lm154-hdm/kniffomat/README.md

# **Kniffomat 🎲**
So you want to build a Kniffomat, a dice rolling automata for all your dice needs. The Kniffomat supports up to 6 dice and can be used to play games like Kniffel, Super-Six and Farkle. This Readme shows you which parts you need and what steps to follow to build your own Kniffomat.

## Trailer
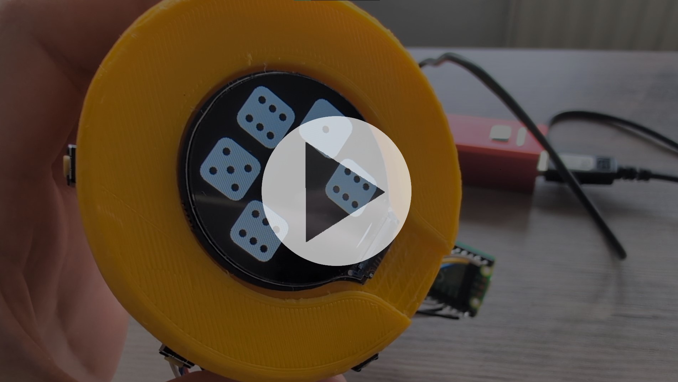
[picture p1: assets/Trailer_Thumbnail.jpg]
(https://youtu.be/IVZKuIQWwR0 "Kniffomat")
  

---

## **Table of Contents**
1. [Features and Controls](#1-features-and-controls)
2. [Hardware Requirements](#2-hardware-requirements)
3. [Case](#3-case)
4. [Wiring](#4-wiring)
5. [Software Logic](#5-software-logic)
6. [Installation and Flashing](#6-installation-and-flashing)
   6.1 [Getting the Firmware](#61-getting-the-firmware)
    * [Option 1: Download from GitLab](#option-1-download-from-gitlab-recommended)
    * [Option 2: Build Natively](#option-2-build-natively)
   
   6.2 [Installing the Firmware](#62-installing-the-firmware)
7. [Assembly](#7-assembly)

   7.1 [Buttons](#71-buttons)

   7.2 [Components](#72-buttons)
   
   7.3 [Notes](#73-notes)
   
---

# 1. Features and Controls
The Kniffomat replaces physical dice with a travel-friendly device. Instead of throwing dice, you shake the cup to roll and use physical buttons to lock your results.

**Locking**: After a roll, press the button corresponding to a die to "lock" it. Locked dice will not change during the next roll  
**Quick Unlock**: Perform a long press on any of the 6 buttons to instantly unlock all dice.  
**Session Setup**: When the device starts, all dice icons blink. During this phase, you can toggle each die "On" or "Off" for the current  session by pressing its button.  
**Rolling the Dice**: Trigger a roll by shaking the device.  

---

# 2. Hardware Requirements
You need to buy the following Components. Its important to buy the Pico 2 H as the pin order and firmware would be different for another model.
| Component | Quantity |Notes |Images |
| :--- | :---: | :--- | :--- |
| **Raspberry Pi Pico 2 H** | 1 | RP235x, pre-soldered headers, Micro-USB | Pico |
| **LCD Display (DEBO LCD 1.28)** | 1 | Round LCD, 240x240 Pixels (GC9A01 driver) | Round TFT|
| **Accelerometer (MPU6050)** | 1 | 3-axis motion sensor | Accelerometer |
| **Push-Buttons** | 6 |Standard 6x6mm tactile switches (e.g. OMR B3F-1002)| Buttons |
| **Breadboard** | 1 | For solderless prototyping |Breadboard|
| **Jumper Wires (M/M)** | ~20 + Spares | To connect all components on the breadboard | Wires |
| **USB Cable** | 1 | USB-A to Micro USB for power and data |Cable|
| **Powerbank** | 1 | Any standard cylindrical 5V USB power supply that fits the case| Powerbank |

---

# 3 Case
The case is made up of a top and a bottom part which have to be printed individually.

Files for the parts are located here: 

**[Top](assets/3D-files/dice_cup_top.stl)**

**[Bottom](assets/3D-files/dice_cup_bottom.stl)**

Use a 3D Printer to print these with your preferred settings.

<details>
<summary><b>Click to expand image of 3D-Print</b></summary>
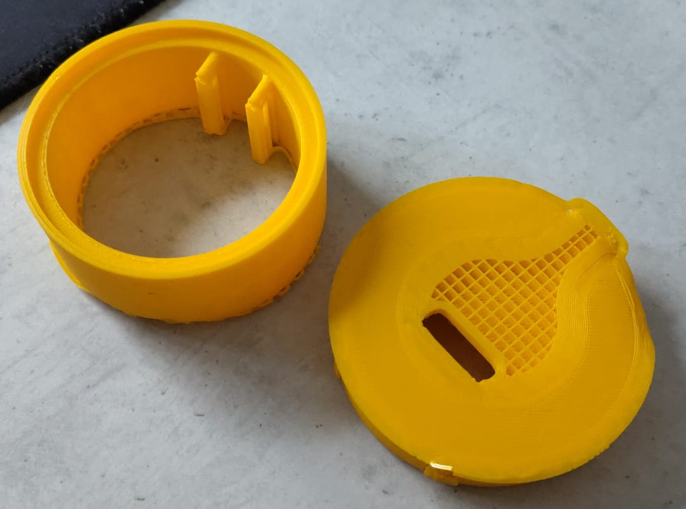
[picture p2: assets/print_image.png]
print_image

</details>

---

# 4. Wiring
This step explains how all parts are connected. You should use a breadboard to prototype all functionality first before soldering everything together.
### **Display (SPI)**

<details>
<summary><b>Click to expand Wiring Diagram</b></summary>
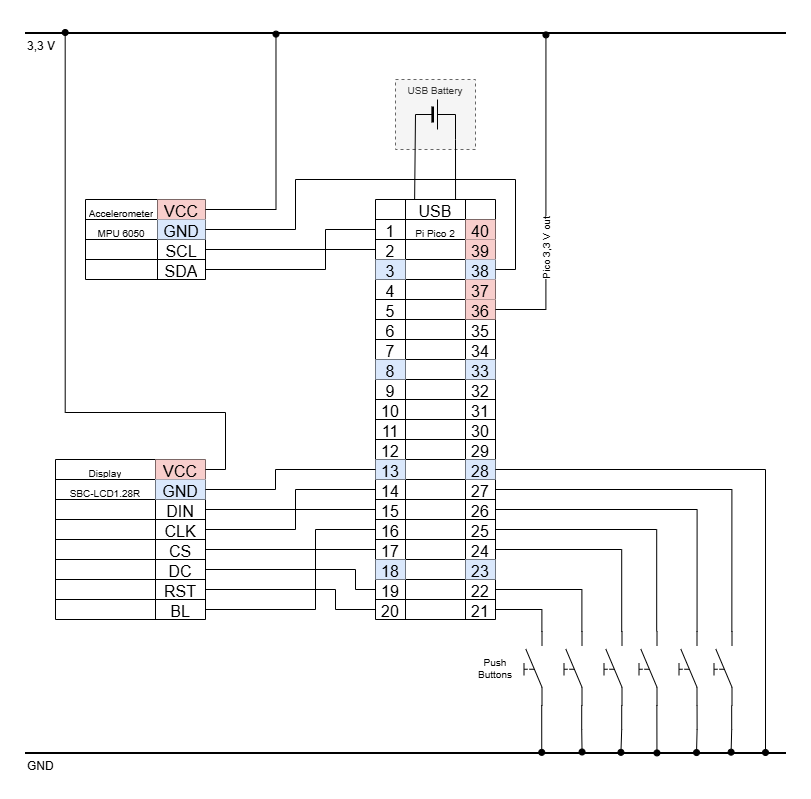
[picture p3: assets/wiring_diagram.png]
wiring_diagram

</details>
<details>
<summary><b>Click to expand Component Diagram</b></summary>
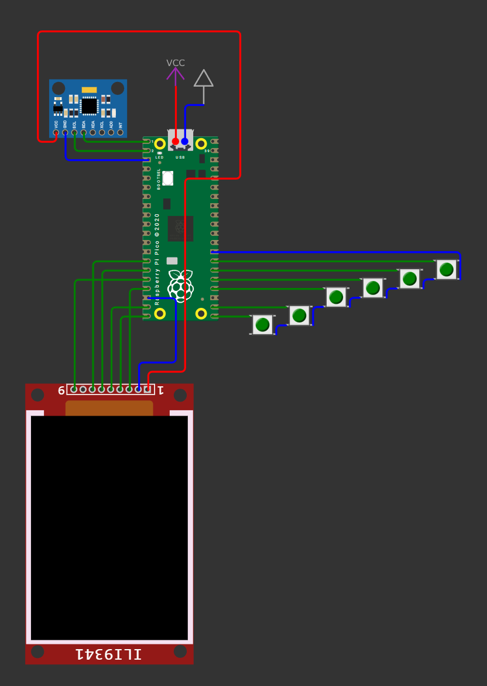
[picture p4: assets/wiring_wokwi_prototype.png]
wiring_wokwi_prototype

</details>
<details>
<summary><b>Click to expand Pin Table</b></summary>

| LCD Pin | Pico GPIO | Physical Pin | Function |
| :--- | :--- | :--- | :--- |
| **DIN** | **GP11** | Pin 15 | SPI TX |
| **CLK** | **GP10** | Pin 14 | SPI Clock |
| **CS** | **GP13** | Pin 17 | Chip Select |
| **DC** | **GP14** | Pin 19 | Data/Command |
| **RST** | **GP15** | Pin 20 | Reset |
| **BL** | **GP12** | Pin 16 | Backlight |

### **Accelerometer (I2C)**

| MPU Pin | Pico GPIO | Physical Pin | Function |
| :--- | :--- | :--- | :--- |
| **SDA** | **GP0** | Pin 1 | I2C Data |
| **SCL** | **GP1** | Pin 2 | I2C Clock |

### **Lock Buttons**
Connect one side to the GPIO and the other to **GND**.

| Button | Pico GPIO | Physical Pin |
| :--- | :--- | :--- |
| **Button 1** | **GP16** | Pin 21 |
| **Button 2** | **GP17** | Pin 22 |
| **Button 3** | **GP18** | Pin 24 |
| **Button 4** | **GP19** | Pin 25 |
| **Button 5** | **GP20** | Pin 26 |
| **Button 6** | **GP21** | Pin 27 |

</details>

---

# 5. Software Logic
<details>
<summary><b>Click to expand</b></summary>
The Kniffomat is structured as a state machine to handle hardware interrupts and UI transitions efficiently.

```mermaid
graph TD
    A[Start: Splash Screen] --> B[Setup: Dice Selection]
    B -->|Press Button| B1[Add/Remove Die]
    B1 --> B
    B --> D[Ready: Default State]
    D -->|Shake| C[Roll Animation]
    C --> D
    D -->|Short Press| E[Lock/Unlock Die]
    E --> D
    D -->|Long Press| F[Quick Unlock All]
    F --> D
```

#### **1. Boot & Setup**
* **Dice Configuration**: The system enters a selection state where dice icons blink. Physical buttons toggle the number of active dice (1–6). This configuration persists for the remainder of the session.

#### **2. The "Roll" Mechanism**
* **Shake Detection**: The accelerometer detects by x and y-axis changes. When a specific threshold is crossed, the system state transitions from `IDLE` to `ROLL`.
* **Pseudo-Randomness**: Results are calculated using a Linear Congruential Generator. It uses a seed generated using the system timer at the moment of the first shake.
* **Visual Feedback**: A visual rolling effect is simulated by the dice blinking 2 times before showing the result.

#### **3. Gameplay & Input**
* **Dice Locking**: In the result state, buttons 1–6 act as toggles. Locking a die flags it to be skipped by the randomizer in the next roll.
* **Lock UI**: Locked dice are highlighted with a red background for high-contrast visibility.
* **Global Clear**: A long-press (>600ms) on any of the buttons unlocks all dice, allowing for a fresh throw.

</details>

---

# 6. Installation and Flashing

---

## 6.1 Getting the Firmware

You can get the firmware for your Pico in one of two ways:
1. **[GitLab Pipeline](#option-1-download-from-gitlab-recommended)**: Let GitLab build it for you and download the result.
2. **[Build Natively](#option-2-build-natively)**: Build it on your own machine (best for development).

### **Option 1: Download from GitLab (Recommended)**

You do not need to install any software to get the latest firmware. You can simply fork this repository and let the GitLab CI/CD pipeline build it for you.

1. **Fork the Project**
   * Click the **Fork** button in the top right of the GitLab repository page.
   * Select your personal namespace.

2. **Run the Pipeline**
   * Go to **Build > Pipelines** in the left sidebar of your forked repository.
   * If a pipeline isn't running already, click **Run pipeline** in the top right.
   * Select the `main` branch and click **Run pipeline**.

3. **Download the Artifacts**
   * Once the pipeline finishes (Green Checkmark ✅), click the **Download** icon on the right side of the pipeline row.
   * Select **Build Artifacts** (or the specific job name, e.g., `build_firmware`).
   * Unzip the download and locate the `.uf2` file.

### **Option 2: Build Natively**

If you want to modify the code or develop locally, follow these steps.

#### **1. Install Build Dependencies**
You need CMake, the ARM GCC compiler, and standard build tools.

**Ubuntu / Debian / Raspberry Pi OS:**
```
sudo apt update
sudo apt install cmake gcc-arm-none-eabi libnewlib-arm-none-eabi build-essential
```

**Fedora:**
```
sudo dnf install cmake arm-none-eabi-gcc-cs arm-none-eabi-newlib make
```

***macOS:***
```
brew install cmake arm-none-eabi-gcc
```

#### **2. Clone the Repository**
```
git clone https://gitlab.mi.hdm-stuttgart.de/embedded/ws25/kniffel.git
cd your-project
```

#### **3. Build the Firmware**
We use PICO_SDK_FETCH_FROM_GIT=ON, so the build system will automatically download the Pico SDK for you during the first configuration.
```
mkdir -p build
cd build

# Configure the project (downloads SDK automatically)
cmake -DPICO_SDK_FETCH_FROM_GIT=ON ..

# Compile
make
```

---

## 6.2 Installing the Firmware
### **1. Enter Bootloader Mode**

1. Unplug the Pico
2. Hold **BOOTSEL**
3. Plug in USB
4. Release BOOTSEL
   A drive appears:

* **RP2350** → Pico 2

### **2. Deploy**

Drag your `.uf2` into the Pico’s USB storage device.

If the file is valid:

* The drive **disappears**
* The Pico **reboots automatically**

If it **stays mounted**, your UF2 is invalid (wrong board, corrupted build, etc.).

### **3. Run**
The Pico will automatically reboot and start the Kniffomat!

---

# 7. Assembly
supplementary images
## 7.1 Buttons
   1. Solder the wires to the 6 buttons
   2. Thread the wires through the openings of the case
   3. Place the buttons into the designated spaces, 
   4. Glue the buttons into place

<details>
<summary><b>Click to expand</b></summary>
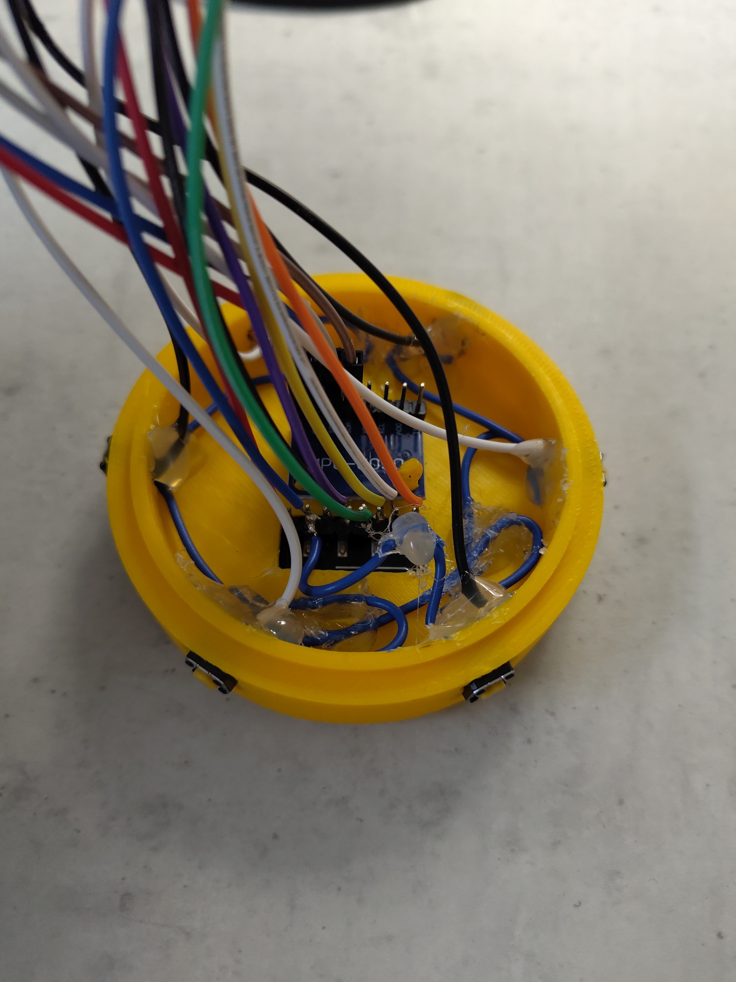
[picture p5: assets/Löten1.jpg]
Löten1

</details>

## 7.2 Components
### Display
   1. Solder the wires to the display side first.
   2. Thread the wires through the holes in the case.
   3. Fit the display into the opening at the top of the casing.
   4. Solder the wires to the Pico

<details>
<summary><b>Click to expand</b></summary>
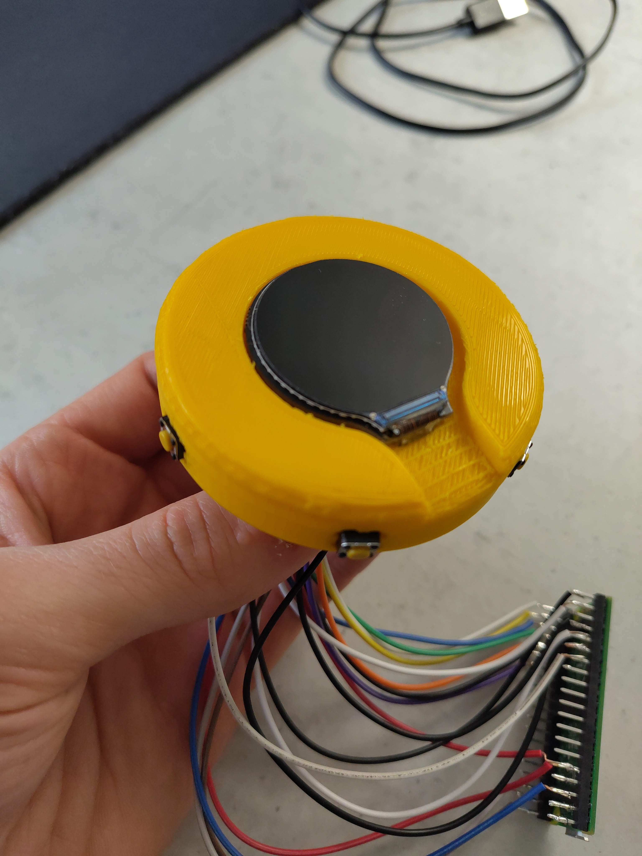
[picture p6: assets/Löten4.jpg]
Löten4

</details>

### Accelerometer
   1. Solder the connections between Pico and accelerometer. 
   2. Gently push the accelerometer onto the attachment pins inside the case.

### Pico
   1. Fit the Pico into the case. 
   2. Glue the Pico into place
   3. Attach the powerbank to the Pico

<details>
<summary><b>Click to expand</b></summary>
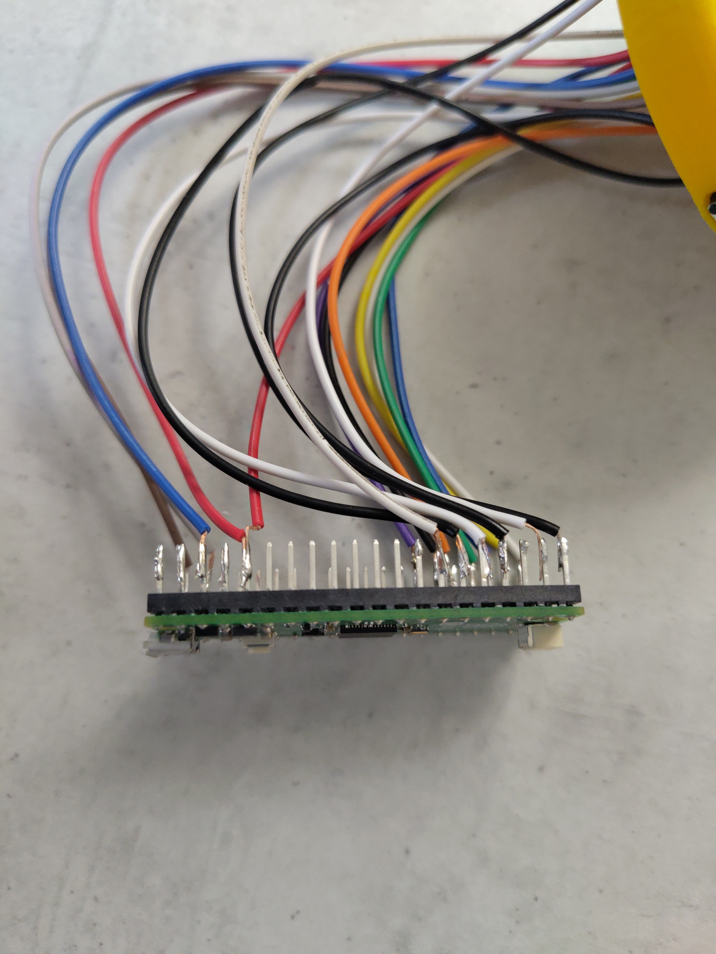
[picture p7: assets/Löten6.jpg]
Löten6

</details>

## 7.3 Notes
- Excessive bending of wires may cause them to break.
- The attachment pins inside the case are fragile and may break easily.

Now your Kniffomat should be ready, try it out by shaking it a few times. The fun has just begun!
