lm154-hdm/kniffomat/assets/Löten2.jpg

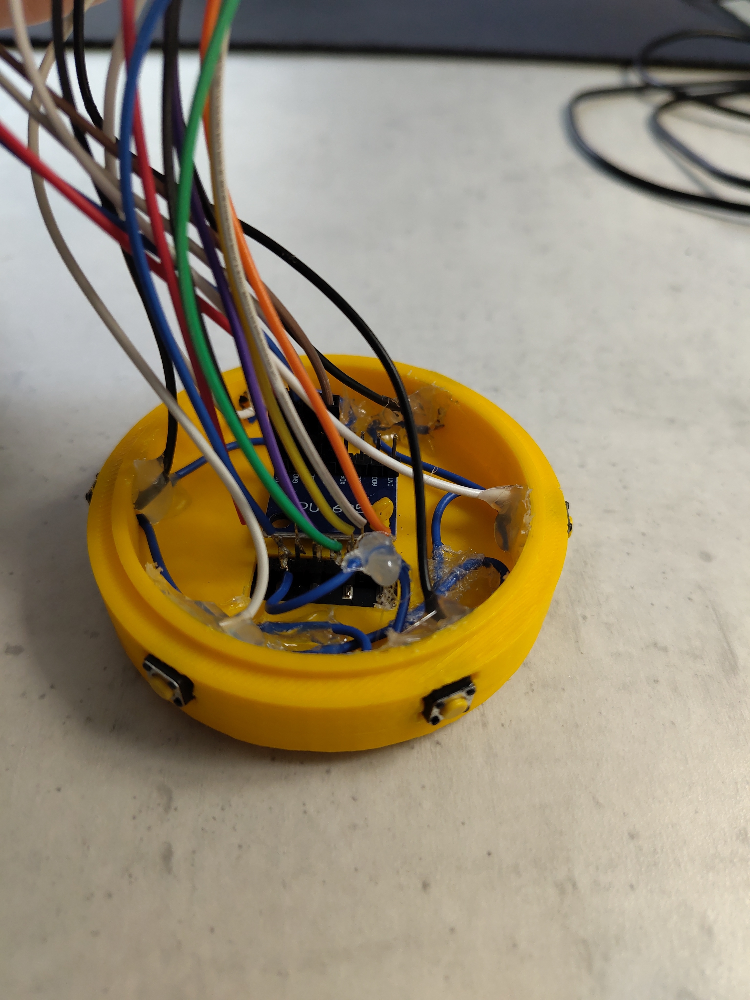
assets/Löten2.jpg
