lm154-hdm/kniffomat/assets/Löten3.jpg

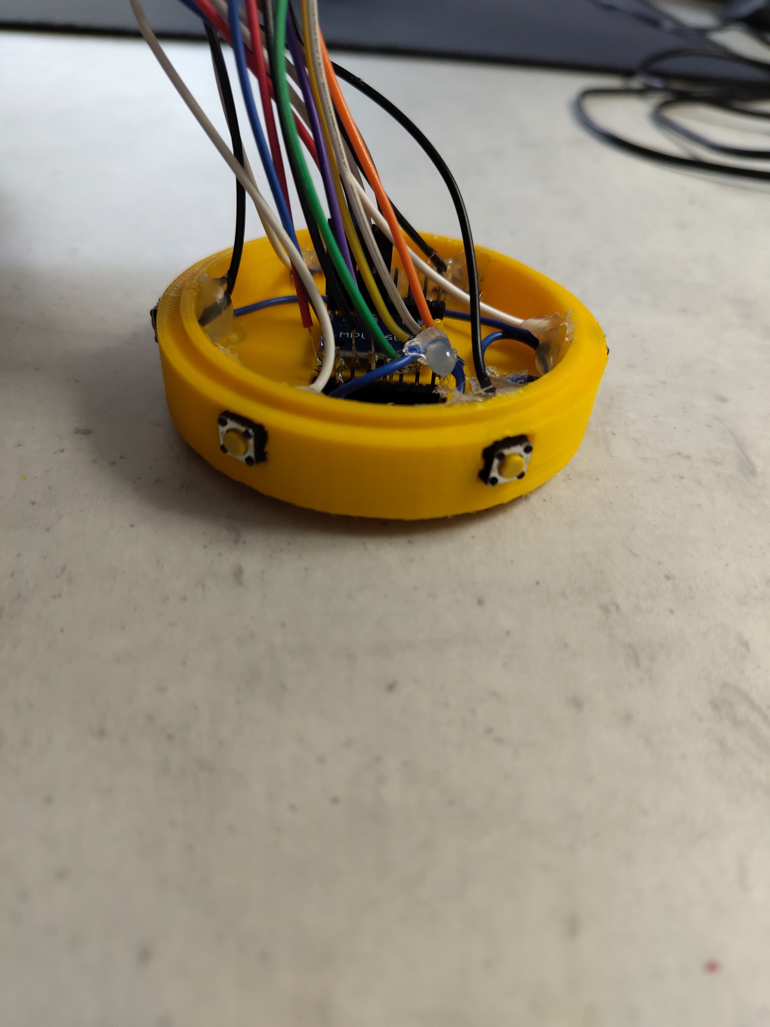
assets/Löten3.jpg
