lm154-hdm/kniffomat/assets/Löten5.jpg

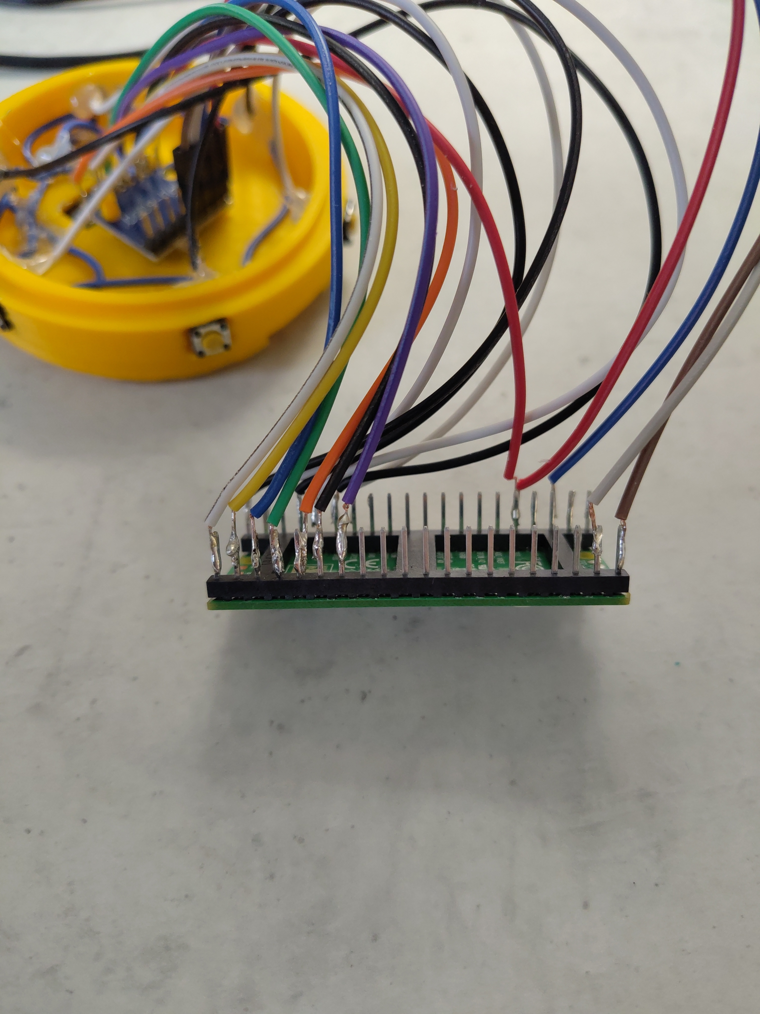
assets/Löten5.jpg
