lm154-hdm/kniffomat/assets/Löten7.jpg

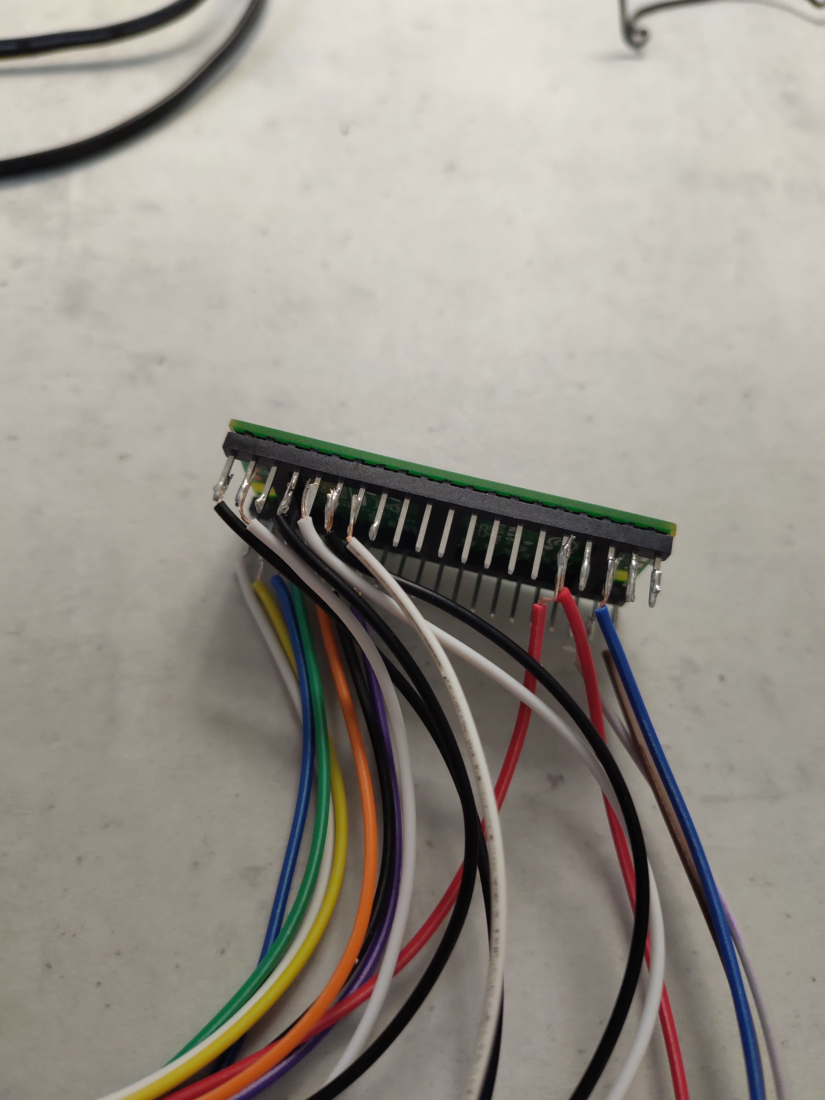
assets/Löten7.jpg
