lm154-hdm/kniffomat/assets/startscreen.jpg

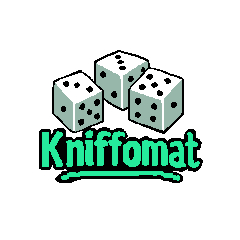
assets/startscreen.jpg
