lm154-hdm/kniffomat/assets/3D-files/dice_cup_bottom.stl

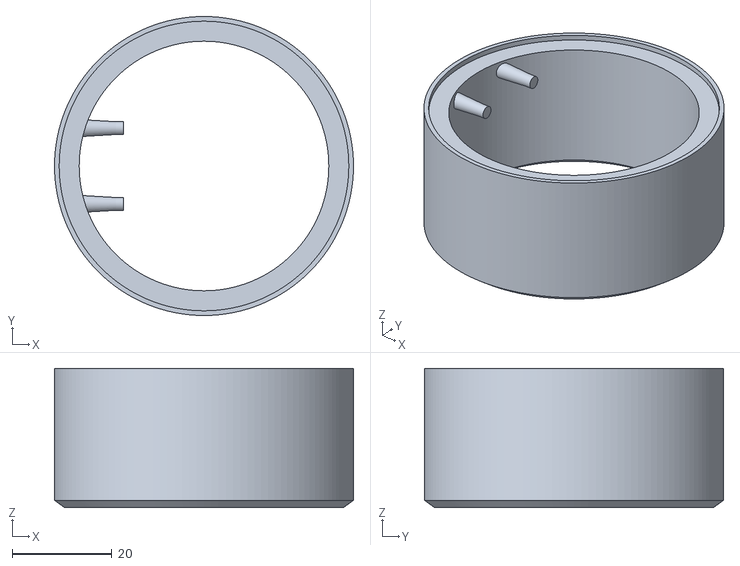
[picture p13: CAD file, 2026-02-06]
assets/3D-files/dice_cup_bottom.stl
60.1 x 60.1 x 27.9
