lm154-hdm/kniffomat/assets/3D-files/dice_cup_top.stl

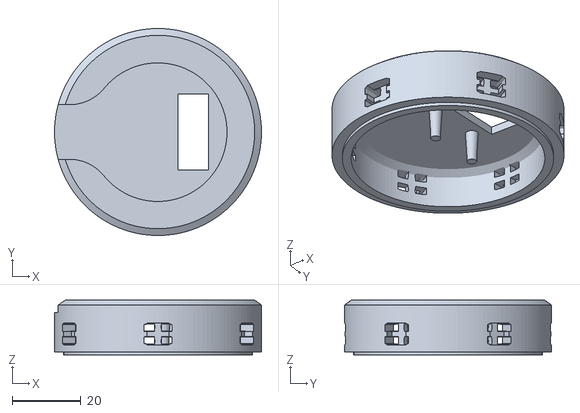
[picture p14: CAD file, 2026-02-06]
assets/3D-files/dice_cup_top.stl
60.1 x 60.1 x 16.0
