lm154-hdm/kniffomat/src/fox.c

#include <stdint.h>
// Image to Byte array conversion tool
// https://javl.github.io/image2cpp/

const uint8_t fox_bytes[] = {
    // 'SampleImage', 240x240px
    0x00, 0x00, 0x00, 0x00, 0x00, 0x00, 0x00, 0x00, 0x00, 0x00, 0x38, 0x07, 0x00, 0x03, 0xff, 0xf0,
    0x00, 0x00, 0x1f, 0xff, 0xff, 0x00, 0x03, 0x80, 0x00, 0x00, 0x00, 0x00, 0x00, 0x00, 0x00, 0x00,
    0x00, 0x00, 0x00, 0x00, 0x00, 0x00, 0x00, 0x00, 0x38, 0x0f, 0x00, 0x07, 0xff, 0xe0, 0x00, 0x00,
    0x1f, 0xff, 0xfe, 0x00, 0x03, 0x00, 0x00, 0x00, 0x00, 0x00, 0x00, 0x00, 0x00, 0x00, 0x00, 0x00,
    0x00, 0x00, 0x00, 0x00, 0x00, 0x00, 0x10, 0x0e, 0x00, 0x07, 0xff, 0x00, 0x00, 0x00, 0x1f, 0xff,
    0xf8, 0x00, 0x01, 0x00, 0x00, 0x00, 0x00, 0x00, 0x00, 0x00, 0x00, 0x00, 0x00, 0x00, 0x00, 0x00,
    0x00, 0x00, 0x00, 0x00, 0x00, 0x00, 0x00, 0x0f, 0xfe, 0x00, 0x00, 0x00, 0x07, 0xfe, 0x20, 0x1c,
    0x00, 0x00, 0x00, 0x00, 0x00, 0x00, 0x00, 0x00, 0x00, 0x00, 0x00, 0x00, 0x00, 0x00, 0x00, 0x00,
    0x00, 0x00, 0x60, 0x00, 0x00, 0x0f, 0xf8, 0x00, 0x00, 0x00, 0x03, 0xfc, 0x31, 0xff, 0x80, 0x00,
    0x00, 0x00, 0x00, 0x00, 0x00, 0x00, 0x00, 0x00, 0x00, 0x00, 0x00, 0x30, 0x00, 0x00, 0x07, 0x00,
    0x60, 0x00, 0x00, 0x1f, 0xe0, 0x00, 0x00, 0x00, 0x03, 0xfc, 0x23, 0xff, 0xe0, 0x00, 0x00, 0x00,
    0x00, 0x00, 0x00, 0x00, 0x00, 0x00, 0x00, 0x00, 0x00, 0x7c, 0x00, 0x00, 0x0f, 0x00, 0xe0, 0x00,
    0x00, 0x1f, 0x80, 0x00, 0x00, 0x00, 0x07, 0xb0, 0x00, 0xff, 0xc0, 0x07, 0x00, 0x00, 0x00, 0x00,
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
    0xff, 0xe0, 0x00, 0x00, 0x00, 0x00, 0x00, 0x01, 0xff, 0xff, 0xff, 0xff, 0xef, 0xff, 0xf7, 0xff,
    0xff, 0xff, 0xff, 0xff, 0xff, 0xff, 0x00, 0x00, 0x03, 0xff, 0x87, 0x90, 0x07, 0xff, 0xff, 0xc0,
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
