lm154-hdm/kniffomat/(commit log)

2025-12-01 ADD .clang-format, FIX formatting c and header files
    [dice.c, helpers.c, helpers.h, main.c]
2025-12-02 FIX comment out unused functions
    [helpers.c, helpers.h]
2025-12-08 bugfix switch to correct pico version
2025-12-08 working init but bugged display stripe
    [gc9a01.c, gc9a01.h, main.c]
2025-12-08 Refactor gc9a01 display driver and enhance functionality
    - Updated gc9a01_init to correct initialization parameters for display settings.
    - Changed gc9a01_set_windows to accept uint16_t parameters for better coordinate handling.
    - Modified gc9a01_clear to adjust window dimensions correctly.
    - Removed unused tft_set_window function and replaced its calls with gc9a01_set_windows in draw_packed_bitmap and draw_artifacted_bitmap functions.
    - Added test code in main to fill the screen with solid colors for verification.
    - Included fox bitmap drawing in the main loop for additional testing.
    [fox.c, gc9a01.c, gc9a01.h, helpers.c, main.c]
2025-12-10 fix black borders on display by removing power control init sequence
    [gc9a01.c, main.c]
2025-12-10 Fix draw_packed_bitmap call for Fox Test
    [main.c]
2025-12-10 Add Gameloop: dice roll triggered by button press, lock/unluck system via buttons incl. visualization
2025-12-16 add onboard led debug check
2025-12-16 Add initialization sequence for accelerometer sensor as function
2025-12-22 add shake detection instead of button press to roll dice
2025-12-22 change shake detection to also considering the y-axis and cleaned up the function.
2025-12-22 remove unused button press function as shake now handles dice rolling
2026-01-12 UPDATE comments FIX minor problems - refactored most comments and added new ones - fixed typo in accelorometer_init.h - deleted some minor unnessecary snippets
    FIX minor cpp problem
    FIX minor clang issue
    FIX PIN_BUTTON in main.c
    FIX header issue and PIN issue
    [accelerometer_init.c, accelerometer_init.h, helpers.c, main.c, shake_detection.c, shake_detection.h]
2026-01-14 fix seed variable undefined error
    [main.c]
2026-01-14 fixed buttons not correctly working as pull-down. changed to pull-up, also fixed handle locking function by removing blocking while loops
    [main.c]
2026-01-20 fix: dice init 0 die
    [main.c]
2026-02-06 add print image
2026-02-06 Upload New File
    [dice_cup_top.stl]
2026-02-07 changed comments for accelerometer functions for better understanding, cleanup accelerometer functions
